SuiNagahoshi/SAM-Mobility-System/H_Bridge.kicad_sch

## KiCad design H_Bridge.kicad_sch (2026-10-19)

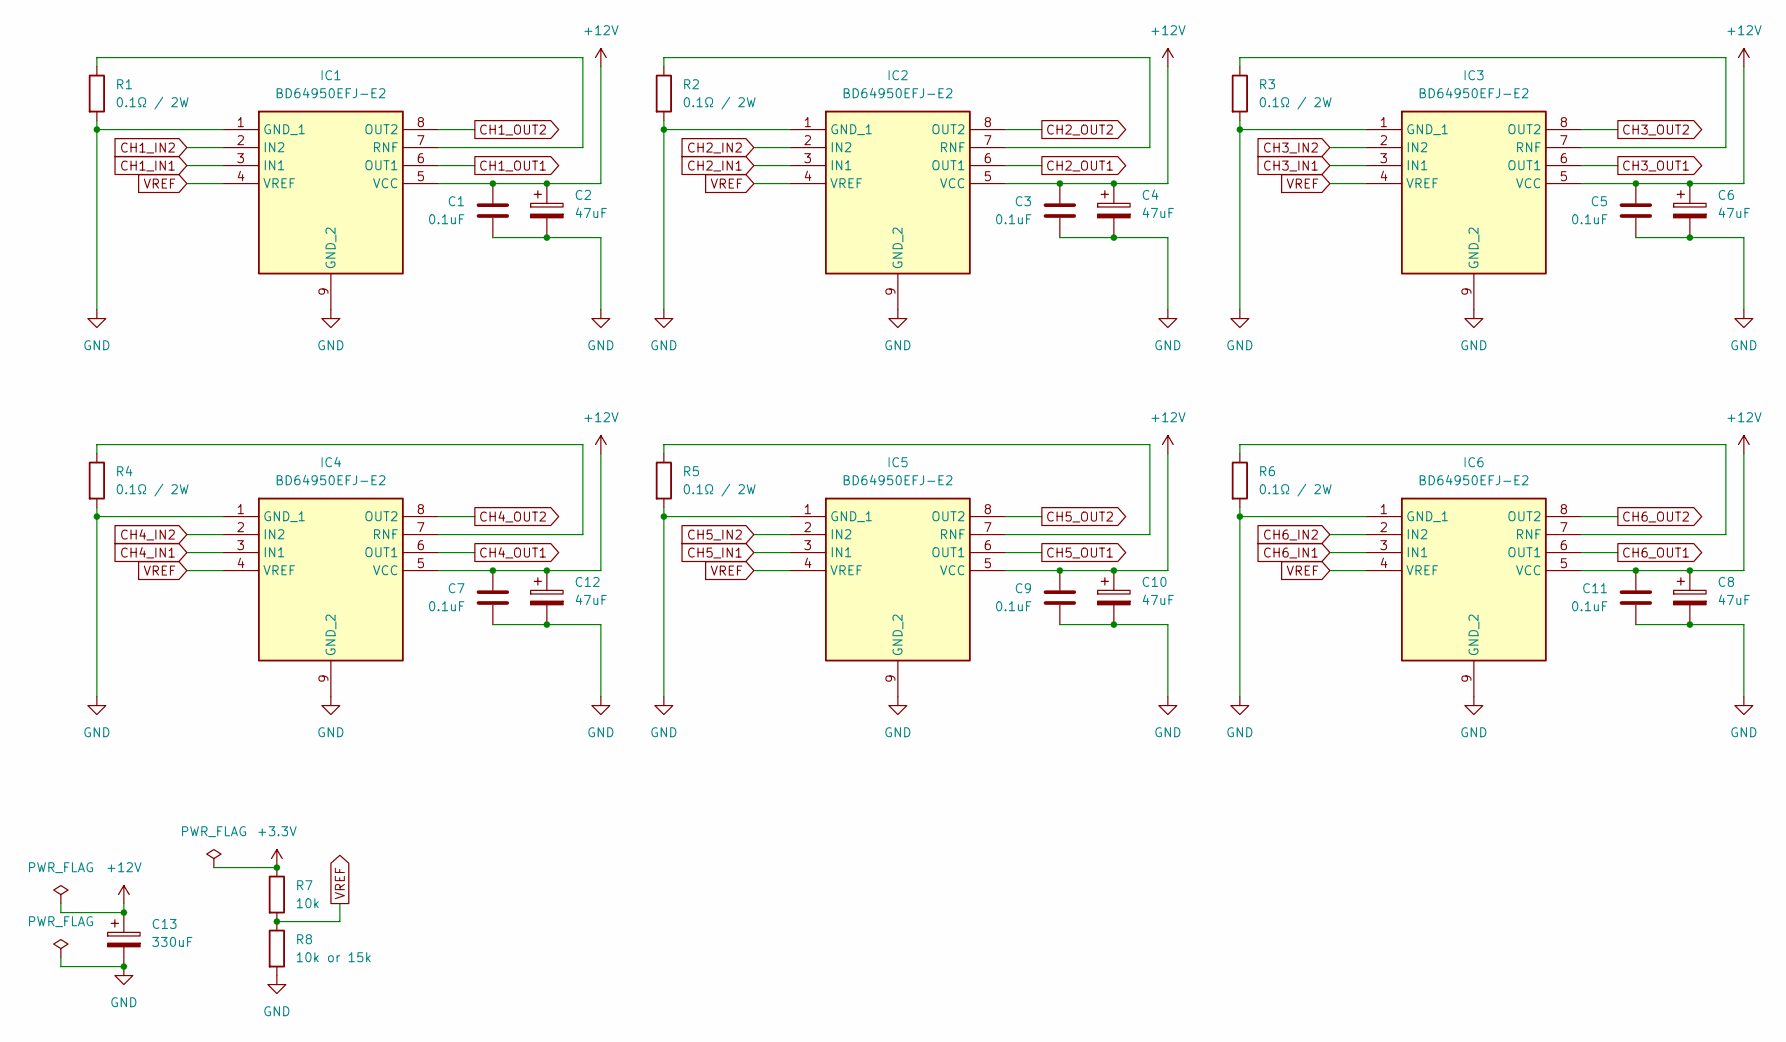
[picture p1: schematic H_Bridge.kicad_sch]

Parts:
C1, C3, C5, C7, C9, C11: 0.1uF; C_0603_1608Metric_Pad1.08x0.95mm_HandSolder; MPN CCTC TCC0603X7R104M500CTS
C2, C4, C6, C8, C10, C12: 47uF; CP_Elec_6.3x7.7; MPN ROQANG VT1H470M0607
C13: 330uF; CP_Elec_10x10.5; MPN ROQANG RVT1H331M1010
IC1, IC2, IC3, IC4, IC5, IC6: BD64950EFJ-E2; HTSOP-J8; Manufacturer_Part_Number BD64950EFJ-E2
R1, R2, R3, R4, R5, R6: 0.1Ω / 2W; R_2512_6332Metric_Pad1.40x3.35mm_HandSolder; MPN RVR HIXD25LR100J
R7: 10k; R_0603_1608Metric_Pad0.98x0.95mm_HandSolder
R8: 10k or 15k; R_0603_1608Metric_Pad0.98x0.95mm_HandSolder

Connections:
+3.3V: R7.1
+12V: C1.1, C2.1, C3.1, C4.1, C5.1, C6.1, C7.1, C8.1, C9.1, C10.1, C11.1, C12.1, C13.1, IC1.5 (VCC), IC2.5 (VCC), IC3.5 (VCC), IC4.5 (VCC), IC5.5 (VCC), IC6.5 (VCC)
CH1_IN1: IC1.3 (IN1)
CH1_IN2: IC1.2 (IN2)
CH1_OUT1: IC1.6 (OUT1)
CH1_OUT2: IC1.8 (OUT2)
CH2_IN1: IC2.3 (IN1)
CH2_IN2: IC2.2 (IN2)
CH2_OUT1: IC2.6 (OUT1)
CH2_OUT2: IC2.8 (OUT2)
CH3_IN1: IC3.3 (IN1)
CH3_IN2: IC3.2 (IN2)
CH3_OUT1: IC3.6 (OUT1)
CH3_OUT2: IC3.8 (OUT2)
CH4_IN1: IC4.3 (IN1)
CH4_IN2: IC4.2 (IN2)
CH4_OUT1: IC4.6 (OUT1)
CH4_OUT2: IC4.8 (OUT2)
CH5_IN1: IC5.3 (IN1)
CH5_IN2: IC5.2 (IN2)
CH5_OUT1: IC5.6 (OUT1)
CH5_OUT2: IC5.8 (OUT2)
CH6_IN1: IC6.3 (IN1)
CH6_IN2: IC6.2 (IN2)
CH6_OUT1: IC6.6 (OUT1)
CH6_OUT2: IC6.8 (OUT2)
GND: C1.2, C2.2, C3.2, C4.2, C5.2, C6.2, C7.2, C8.2, C9.2, C10.2, C11.2, C12.2, C13.2, IC1.1 (GND_1), IC1.9 (GND_2), IC2.1 (GND_1), IC2.9 (GND_2), IC3.1 (GND_1), IC3.9 (GND_2), IC4.1 (GND_1), IC4.9 (GND_2), IC5.1 (GND_1), IC5.9 (GND_2), IC6.1 (GND_1), IC6.9 (GND_2), R1.2, R2.2, R3.2, R4.2, R5.2, R6.2, R8.2
unnamed: IC1.7 (RNF), R1.1
unnamed: IC2.7 (RNF), R2.1
unnamed: IC3.7 (RNF), R3.1
unnamed: IC4.7 (RNF), R4.1
unnamed: IC5.7 (RNF), R5.1
unnamed: IC6.7 (RNF), R6.1
VREF: IC1.4 (VREF), IC2.4 (VREF), IC3.4 (VREF), IC4.4 (VREF), IC5.4 (VREF), IC6.4 (VREF), R7.2, R8.1
