SuiNagahoshi/SAM-Mobility-System/W5500.kicad_sch

## KiCad design W5500.kicad_sch (2026-10-21)

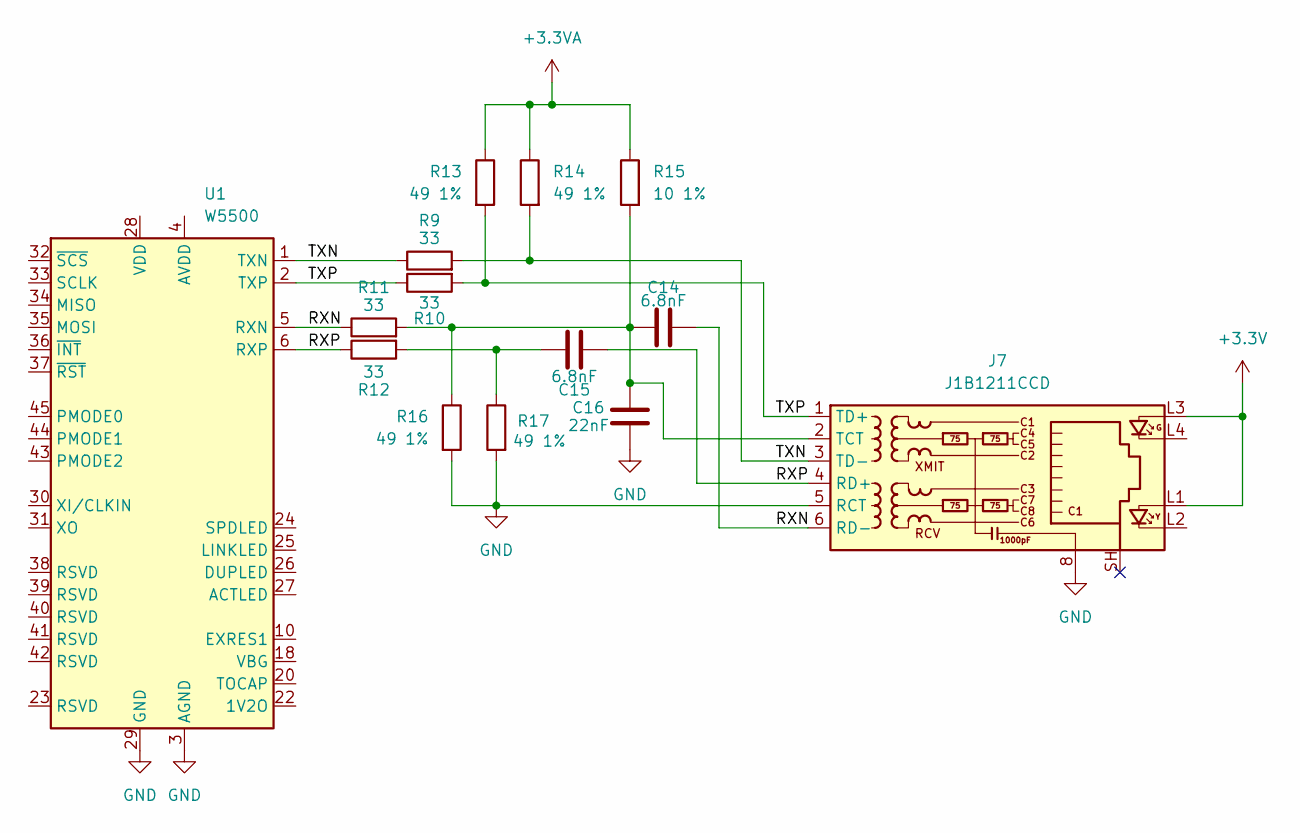
[picture p2: schematic W5500.kicad_sch]

Parts:
C14, C15: 6.8nF; C_0402_1005Metric_Pad0.74x0.62mm_HandSolder
C16: 22nF; C_0402_1005Metric_Pad0.74x0.62mm_HandSolder
J7: J1B1211CCD; RJ45_Bel_SI-60062-F; MPN WIZNET J1B1211CCD
R9, R10, R11, R12: 33; R_0402_1005Metric_Pad0.72x0.64mm_HandSolder
R13, R14, R16, R17: 49 1%; R_0402_1005Metric_Pad0.72x0.64mm_HandSolder
R15: 10 1%; R_0402_1005Metric_Pad0.72x0.64mm_HandSolder
U1: W5500; LQFP-48_7x7mm_P0.5mm

Connections:
+3.3V: J7.L1, J7.L3
+3.3VA: R13.1, R14.1, R15.1
GND: C16.2, J7.5 (RCT), J7.8, R16.2, R17.2, U1.3 (AGND), U1.9 (AGND), U1.14 (AGND), U1.16 (AGND), U1.19 (AGND), U1.29 (GND), U1.48 (AGND)
unnamed: C14.1, C16.1, J7.2 (TCT), R11.2, R15.2, R16.1
unnamed: C15.1, R12.2, R17.1
unnamed: U1.4 (AVDD), U1.8 (AVDD), U1.11 (AVDD), U1.15 (AVDD), U1.17 (AVDD), U1.21 (AVDD)
RXN: C14.2, J7.6 (RD-), R11.1, U1.5 (RXN)
RXP: C15.2, J7.4 (RD+), R12.1, U1.6 (RXP)
TXN: J7.3 (TD-), R9.1, R9.2, R14.2, U1.1 (TXN)
TXP: J7.1 (TD+), R10.1, R10.2, R13.2, U1.2 (TXP)
