SuiNagahoshi/SAM-Mobility-System/rover-mobility-system.kicad_sch

## KiCad design rover-mobility-system.kicad_sch (2026-10-20)

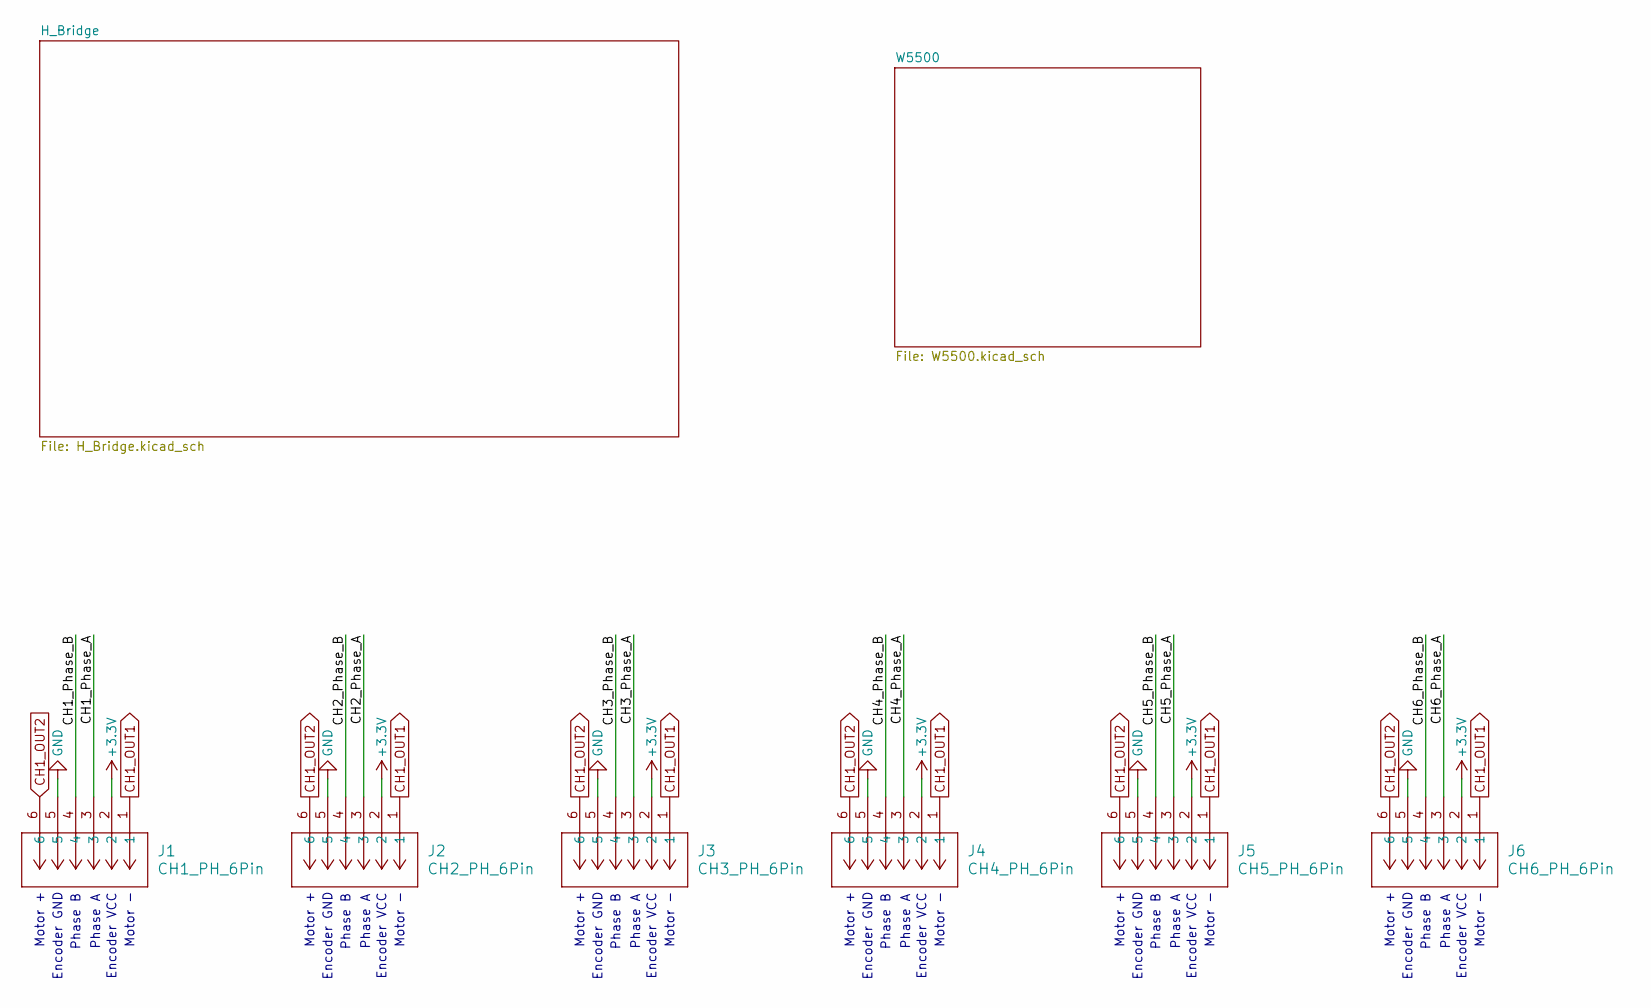
[picture p3: schematic rover-mobility-system.kicad_sch]

Parts:
J1: CH1_PH_6Pin; S6B-PH-SM4-TB_LF__SN__3
J2: CH2_PH_6Pin; S6B-PH-SM4-TB_LF__SN__3
J3: CH3_PH_6Pin; S6B-PH-SM4-TB_LF__SN__3
J4: CH4_PH_6Pin; S6B-PH-SM4-TB_LF__SN__3
J5: CH5_PH_6Pin; S6B-PH-SM4-TB_LF__SN__3
J6: CH6_PH_6Pin; S6B-PH-SM4-TB_LF__SN__3

Connections:
+3.3V: J1.2, J2.2, J3.2, J4.2, J5.2, J6.2
CH1_OUT1: J1.1, J2.1, J3.1, J4.1, J5.1, J6.1
CH1_OUT2: J1.6, J2.6, J3.6, J4.6, J5.6, J6.6
CH1_Phase_A: J1.3
CH1_Phase_B: J1.4
CH2_Phase_A: J2.3
CH2_Phase_B: J2.4
CH3_Phase_A: J3.3
CH3_Phase_B: J3.4
CH4_Phase_A: J4.3
CH4_Phase_B: J4.4
CH5_Phase_A: J5.3
CH5_Phase_B: J5.4
CH6_Phase_A: J6.3
CH6_Phase_B: J6.4
GND: J1.5, J2.5, J3.5, J4.5, J5.5, J6.5

Notes on the sheet:
Encoder VCC
Motor +
Phase B
Encoder GND
Phase A
Motor -
