SuiNagahoshi/SAM-Mobility-System/(commit log)

2026-10-20 add w5500 schematic
2026-10-22 servo: slew-limit angle commands for gentle motion
